recursivenomad/index-audio-amplifier/README.md

🎧 **Tiny USB-C audio amplifier for off-ear BMR speakers**
===========================================================

&nbsp;

> &nbsp;
> ### ***Work in progress***
> &nbsp;

&nbsp;

***Features***
==============

*Coming soon...*

&nbsp;

***How to use***
================

*Coming soon...*

&nbsp;

***License / Access***
======================

This original work is freely available under your choice of the [*MIT-0*](./LICENSE.txt) license or [*CC0-1.0*][URL-CC0] public domain dedication.  
Although attribution is not required, sharing when you've made something with my work is really cool 💖

----------------------

*Repository: <https://gitlab.com/recursivenomad/index-audio-amplifier/>*  
*Contact: <recursivenomad@protonmail.com>*

----------------------

[URL-MIT-0]: <https://opensource.org/license/mit-0/>
[URL-CC0]: <https://creativecommons.org/publicdomain/zero/1.0/>
