recursivenomad/index-audio-amplifier/src/index-audio-amplifier.kicad_pcb

## KiCad design src/index-audio-amplifier.kicad_pcb (2025-08-19)

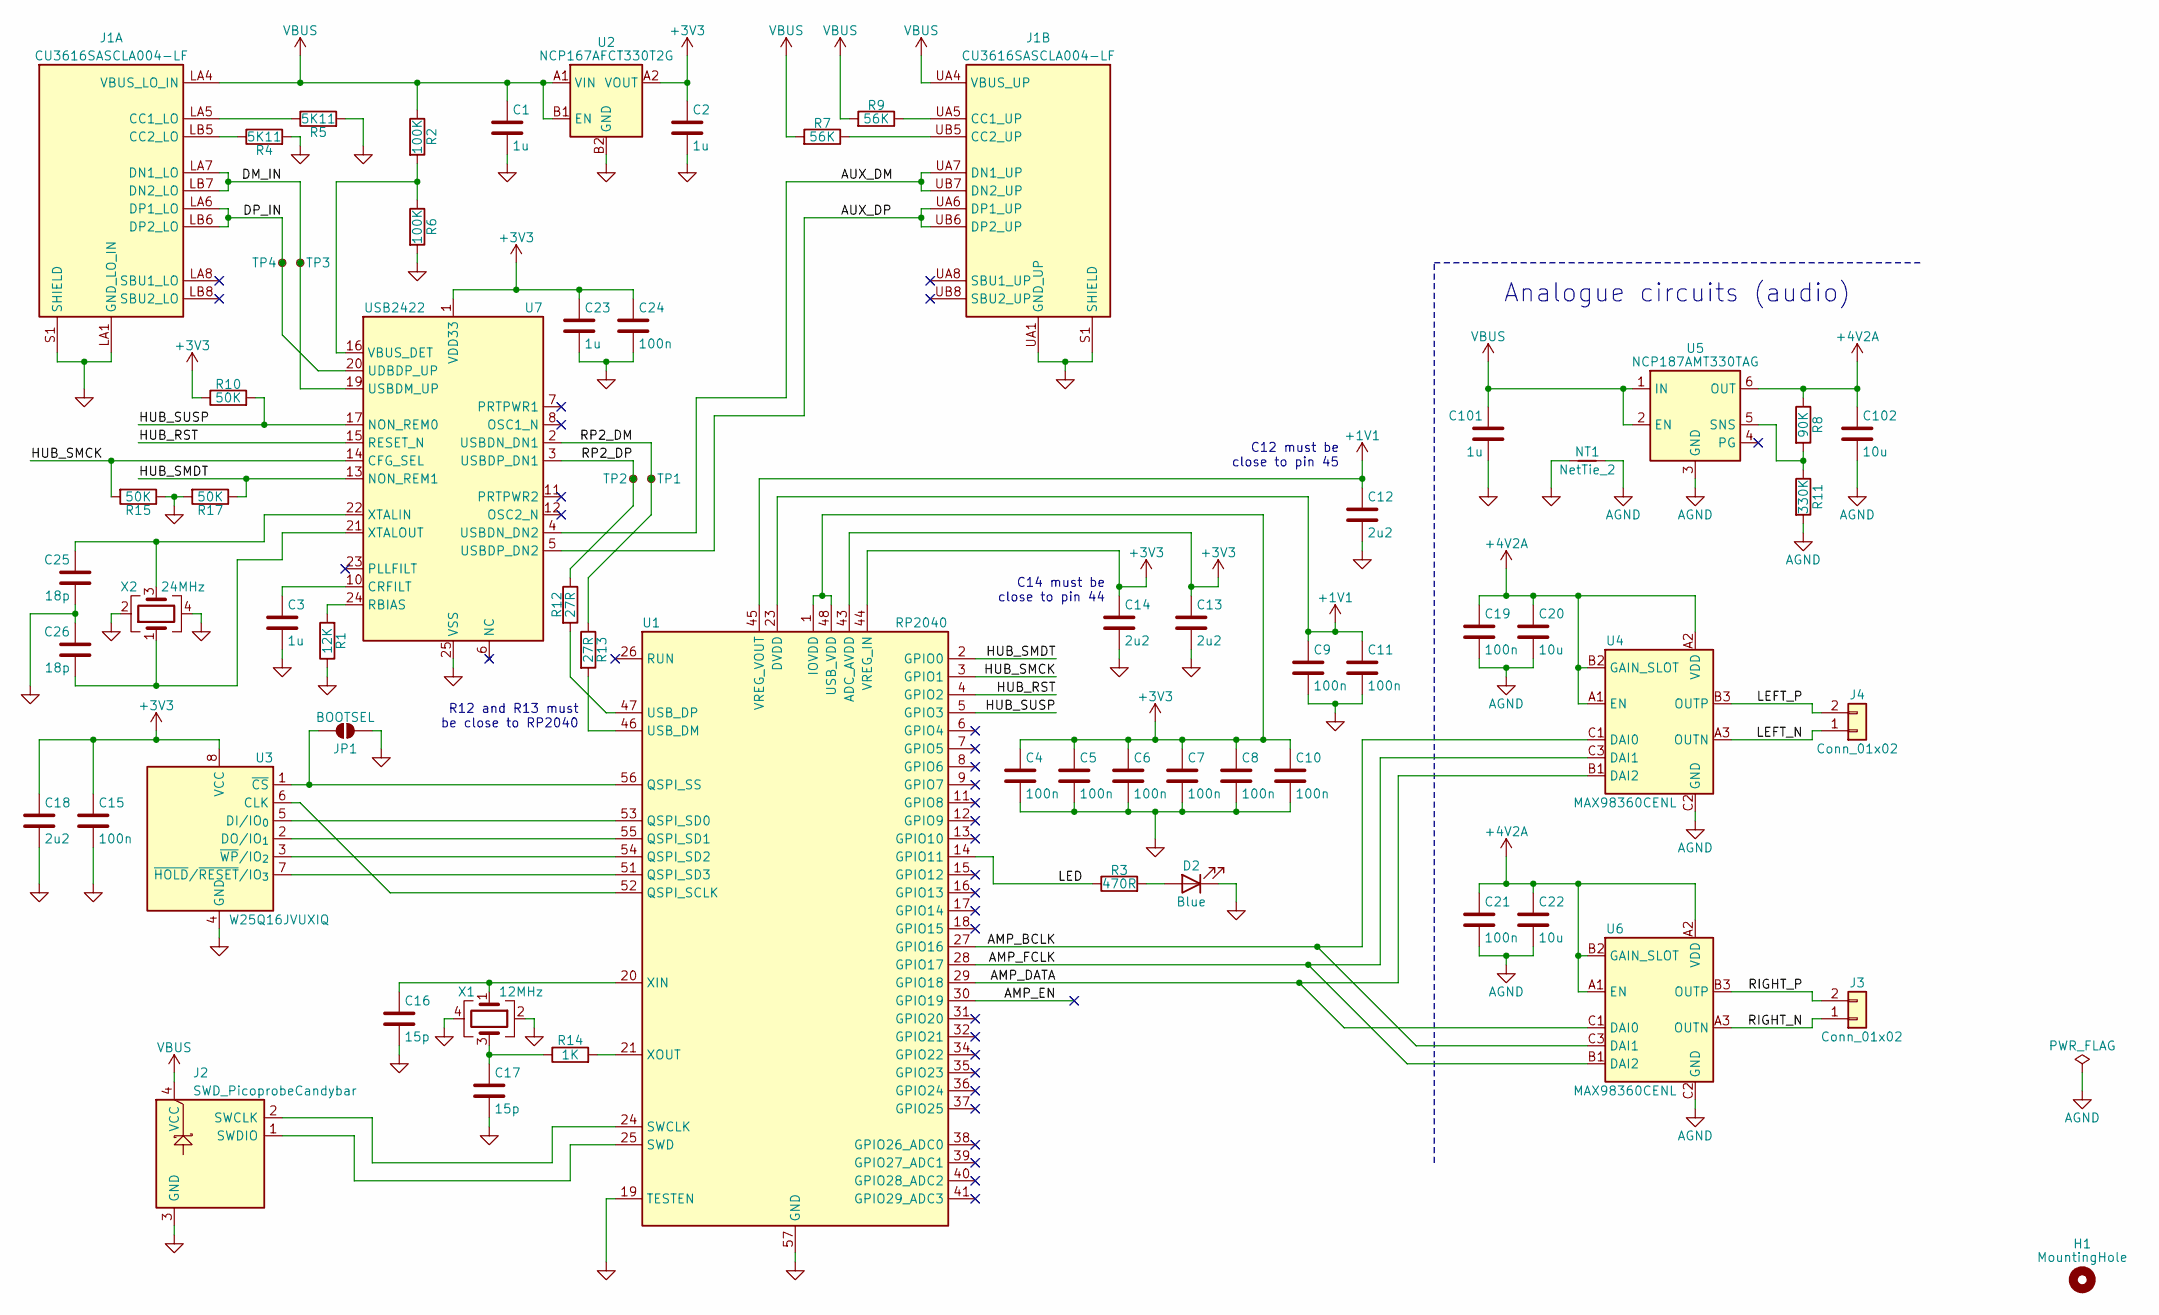
[picture p1: schematic index-audio-amplifier.kicad_sch, Index Audio Amplifier]

Parts:
C1, C2, C3, C23, C101: 1u; C_0402_1005Metric
C4, C5, C6, C7, C8, C9, C10, C11, C15, C19, C21, C24: 100n; C_0402_1005Metric
C12, C13, C14: 2u2; C_01005_0402Metric
C16, C17: 15p; C_0402_1005Metric
C18: 2u2; C_0402_1005Metric
C20, C22, C102: 10u; C_0402_1005Metric
C25, C26: 18p; C_0402_1005Metric
D2: Blue; LED_0603_1608Metric
H1: MountingHole; MountingHole_2.2mm_M2_ISO7380
J1: CU3616SASCLA004-LF; USB_C_Receptacle_CviLux_CU36SASCLA004-LF
J2: SWD_PicoprobeCandybar; SWD_PicoprobeCandybar_PressFit_Compact
J3, J4: Conn_01x02; PinHeader_1x02_P1.00mm_Vertical
JP1: BOOTSEL; SolderJumper-2_P1.0mm_Open_RoundedPad0.5x1.0mm
NT1: NetTie_2; NetTie-2_SMD_Pad0.5mm
R1: 12K; R_0402_1005Metric
R2, R6: 100K; R_0402_1005Metric
R3: 470R; R_0402_1005Metric
R4, R5: 5K11; R_0402_1005Metric
R7, R9: 56K; R_0402_1005Metric
R8: 90K; R_0402_1005Metric
R10, R15, R17: 50K; R_0402_1005Metric
R11: 330K; R_0402_1005Metric
R12, R13: 27R; R_0402_1005Metric
R14: 1K; R_0402_1005Metric
TP1, TP2, TP3, TP4: TestPoint_Small; TestPoint_Pad_D0.5mm
U1: RP2040; QFN-56-1EP_7x7mm_P0.4mm_EP3.2x3.2mm
U2: NCP167AFCT330T2G; WLCSP-4_0.64x0.64mm_Layout2x2_P0.35mm
U3: W25Q16JVUXIQ; Winbond_USON-8-1EP_3x2mm_P0.5mm_EP0.2x1.6mm
U4, U6: MAX98360CENL; WLP-9_1.347x1.347mm_Layout3x3_P0.4mm
U5: NCP187AMT330TAG; DFN-6-1EP_2x2mm_P0.65mm_EP1.01x1.7mm
U7: USB2422; VQFN-24-1EP_4x4mm_P0.5mm_EP2.5x2.5mm_ThermalVias
X1: 12MHz; Crystal_SMD_3225-4Pin_3.2x2.5mm
X2: 24MHz; Crystal_SMD_3225-4Pin_3.2x2.5mm

Connections:
+1V1: C9.1, C11.1, C12.1, U1.23 (DVDD), U1.45 (VREG_VOUT), U1.50 (DVDD)
+3V3: C2.1, C4.1, C5.1, C6.1, C7.1, C8.1, C10.1, C13.1, C14.1, C15.1, C18.1, C23.1, C24.1, R10.1, U1.1 (IOVDD), U1.10 (IOVDD), U1.22 (IOVDD), U1.33 (IOVDD), U1.42 (IOVDD), U1.43 (ADC_AVDD), U1.44 (VREG_IN), U1.48 (USB_VDD), U1.49 (IOVDD), U2.A2 (VOUT), U3.8 (VCC), U7.1 (VDD33), U7.9 (VDD33), U7.18 (VDD33)
+4V2A: C19.1, C20.1, C21.1, C22.1, C102.1, R8.1, U4.A1 (EN), U4.A2 (VDD), U4.B2 (GAIN_SLOT), U5.6 (OUT), U6.A1 (EN), U6.A2 (VDD), U6.B2 (GAIN_SLOT)
/AMP_BCLK: U1.27 (GPIO16), U4.C1 (DAI0), U6.C3 (DAI1)
/AMP_DATA: U1.29 (GPIO18), U4.B1 (DAI2), U6.C1 (DAI0)
/AMP_EN: U1.30 (GPIO19)
/AMP_FCLK: U1.28 (GPIO17), U4.C3 (DAI1), U6.B1 (DAI2)
/AUX_DM: J1.UA7 (DN1_UP), J1.UB7 (DN2_UP), U7.4 (USBDN_DN2)
/AUX_DP: J1.UA6 (DP1_UP), J1.UB6 (DP2_UP), U7.5 (USBDP_DN2)
/DM_IN: J1.LA7 (DN1_LO), J1.LB7 (DN2_LO), TP3.1, U7.19 (USBDM_UP)
/DP_IN: J1.LA6 (DP1_LO), J1.LB6 (DP2_LO), TP4.1, U7.20 (UDBDP_UP)
/HUB_RST: U1.4 (GPIO2), U7.15 (RESET_N)
/HUB_SMCK: R15.2, U1.3 (GPIO1), U7.14 (CFG_SEL)
/HUB_SMDT: R17.1, U1.2 (GPIO0), U7.13 (NON_REM1)
/HUB_SUSP: R10.2, U1.5 (GPIO3), U7.17 (NON_REM0)
/LED: R3.1, U1.14 (GPIO11)
/LEFT_N: J4.1, U4.A3 (OUTN)
/LEFT_P: J4.2, U4.B3 (OUTP)
/RIGHT_N: J3.1, U6.A3 (OUTN)
/RIGHT_P: J3.2, U6.B3 (OUTP)
/RP2_DM: R13.1, TP1.1, U7.2 (USBDN_DN1)
/RP2_DP: R12.1, TP2.1, U7.3 (USBDP_DN1)
AGND: C19.2, C20.2, C21.2, C22.2, C102.2, NT1.2, R11.2, U4.C2 (GND), U5.3 (GND), U5.7 (GND), U6.C2 (GND)
GND: C1.2, C2.2, C3.2, C4.2, C5.2, C6.2, C7.2, C8.2, C9.2, C10.2, C11.2, C12.2, C13.2, C14.2, C15.2, C16.2, C17.2, C18.2, C23.2, C24.2, C25.2, C26.1, C101.2, D2.1 (K), J1.LA1 (GND_LO_IN), J1.LA12 (GND_LO), J1.LB1 (GND_LO), J1.LB12 (GND_LO), J1.S1 (SHIELD), J1.UA1 (GND_UP), J1.UA12 (GND_UP), J1.UB1 (GND_UP), J1.UB12 (GND_UP), J2.3 (GND), JP1.2 (B), NT1.1, R1.1, R4.2, R5.2, R6.2, R15.1, R17.2, U1.19 (TESTEN), U1.57 (GND), U2.B2 (GND), U3.4 (GND), U7.25 (VSS), X1.2, X1.4, X2.2, X2.4
unnamed: C17.1, R14.1, X1.3
unnamed: D2.2 (A), R3.2
unnamed: J1.LA5 (CC1_LO), R5.1
unnamed: J1.LB5 (CC2_LO), R4.1
unnamed: J1.UA5 (CC1_UP), R9.1
unnamed: J1.UB5 (CC2_UP), R7.1
unnamed: J2.2 (SWCLK), U1.24 (SWCLK)
unnamed: J2.1 (SWDIO), U1.25 (SWD)
unnamed: JP1.1 (A), U1.56 (QSPI_SS), U3.1 (~CS)
unnamed: U1.52 (QSPI_SCLK), U3.6 (CLK)
unnamed: U1.53 (QSPI_SD0), U3.5 (DI/IO_{0})
unnamed: U1.55 (QSPI_SD1), U3.2 (DO/IO_{1})
unnamed: U1.54 (QSPI_SD2), U3.3 (~WP/IO_{2})
unnamed: U1.51 (QSPI_SD3), U3.7 (~HOLD/~RESET/IO_{3})
unnamed: R13.2, U1.46 (USB_DM)
unnamed: R12.2, U1.47 (USB_DP)
unnamed: C16.1, U1.20 (XIN), X1.1
unnamed: R14.2, U1.21 (XOUT)
unnamed: R8.2, R11.1, U5.5 (SNS)
unnamed: C3.1, U7.10 (CRFILT)
unnamed: R1.2, U7.24 (RBIAS)
unnamed: R2.2, R6.1, U7.16 (VBUS_DET)
unnamed: C25.1, U7.22 (XTALIN), X2.3
unnamed: C26.2, U7.21 (XTALOUT), X2.1
VBUS: C1.1, C101.1, J1.LA4 (VBUS_LO_IN), J1.LA9 (VBUS_LO), J1.LB4 (VBUS_LO), J1.LB9 (VBUS_LO), J1.UA4 (VBUS_UP), J1.UA9 (VBUS_UP), J1.UB4 (VBUS_UP), J1.UB9 (VBUS_UP), J2.4 (VCC), R2.1, R7.2, R9.2, U2.A1 (VIN), U2.B1 (EN), U5.1 (IN), U5.2 (EN)

Notes on the sheet:
C14 must be close to pin 44
R12 and R13 must be close to RP2040
C12 must be close to pin 45
Analogue circuits (audio)

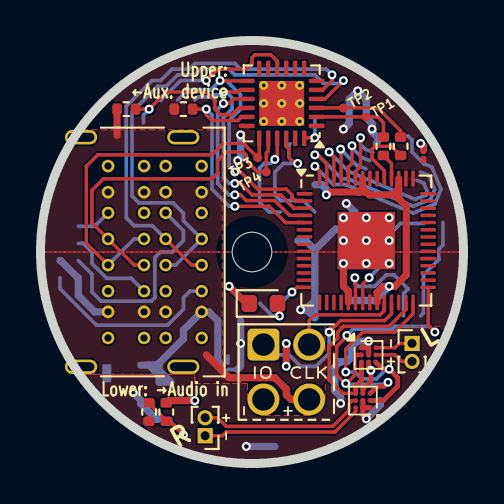
[picture p2: board index-audio-amplifier.kicad_pcb from above]

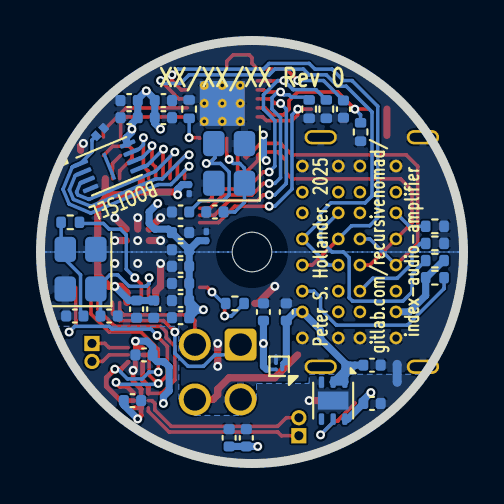
[picture p3: board index-audio-amplifier.kicad_pcb from below]

Board: 2 copper layers, 23.5 x 23.5 mm, 65 parts (45 on the bottom side), 48 nets.
