recursivenomad/index-audio-amplifier/(commit log)

2025-08-12 Initialize project
    KiCad 9.0.3
    [index-audio-amplifier.kicad_pcb, index-audio-amplifier.kicad_sch]
2025-08-12 Initialize project files
    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
    [index-audio-amplifier.kicad_pcb, index-audio-amplifier.kicad_sch]
2025-08-12 Add & associate `compact-title-block` submodule
    [index-audio-amplifier.kicad_pcb, index-audio-amplifier.kicad_sch]
2025-08-13 Draw targeted in-situ reference for board layout
    Geometry approximated from Valve Index HMD using calipers
    [index-audio-amplifier.kicad_pcb]
2025-08-13 Create board edge, 0.5mm clearance from nominal
    [index-audio-amplifier.kicad_pcb]
2025-08-13 Recreate Pico schematic (ignoring connectors)
    <https://datasheets.raspberrypi.com/pico/pico-datasheet.pdf#pico-schematic-diagram>
    [index-audio-amplifier.kicad_sch]
2025-08-13 Add discrete component proximity notes
    Notes adopted from `RP2040_minimal_r2.kicad_pro` in "Minimal-KiCAD.zip"
    from "Hardware design with RP2040":
    <https://datasheets.raspberrypi.com/rp2040/hardware-design-with-rp2040.pdf#minimal-design-example>
    [index-audio-amplifier.kicad_sch]
2025-08-13 Add PCM5101A for `usb_sound_card` firmware
    Component selection adopted from `pico_vga_sd_aud.pro` in
    "VGA_KiCAD.zip" from "Hardware design with RP2040":
    <https://datasheets.raspberrypi.com/rp2040/hardware-design-with-rp2040.pdf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>
    Referenced firmware is on the branch `usb-sound-card` in the
    index-audio-interface repository:
    <https://gitlab.com/recursivenomad/index-audio-interface/-/tree/usb-sound-card/>
    Which itself is rebased from Raspberry Pi's pico-playground repository:
    <https://github.com/raspberrypi/pico-playground/tree/master/apps/usb_sound_card>
    [index-audio-amplifier.kicad_sch]
2025-08-13 Move I2S pins to match `picoamp` firmware
    Refererenced firmware is on the branch `picoamp-rebase` in the
    <https://gitlab.com/recursivenomad/index-audio-interface/-/tree/picoamp-rebase/>
    Which itself is rebased from sctanf's picoamp `main` branch:
    <https://github.com/sctanf/picoamp/>
    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
    [index-audio-amplifier.kicad_sch]
2025-08-13 Replace PCM5101A with 2 MAX98360CENL
    Should be functionally matched to the picoamp firmware now.
    Schematic follows stereo "Typical Application Circuit" from MAX98360x
    datasheet:
    <https://www.analog.com/media/en/technical-documentation/data-sheets/max98360a-max98360d.pdf>
    [index-audio-amplifier.kicad_sch]
2025-08-13 Remove DNP resistors
    [index-audio-amplifier.kicad_sch]
2025-08-13 Associate remaining footprints
    [index-audio-amplifier.kicad_sch]
2025-08-13 Remove unused analogue VSYS monitor (GPIO29)
    [index-audio-amplifier.kicad_sch]
2025-08-13 Remove external analogue reference
    [index-audio-amplifier.kicad_sch]
2025-08-13 Add debug interface
    [index-audio-amplifier.kicad_sch]
2025-08-13 Add screwhead keepout
    [index-audio-amplifier.kicad_pcb]
2025-08-13 Replace Micro-USB with USC-C
    [index-audio-amplifier.kicad_sch]
2025-08-13 Change audio GND to AGND; add MountingHole
    [index-audio-amplifier.kicad_sch]
2025-08-14 Add connectors for speaker outputs
    [index-audio-amplifier.kicad_sch]
2025-08-14 Change MAX98360CENL footprint to custom WLP-9
    [index-audio-amplifier.kicad_sch]
2025-08-14 Downsize discrete components & swap connectors
    [index-audio-amplifier.kicad_sch]
2025-08-14 Net tie GND to AGND & isolate analogue circuits
    [index-audio-amplifier.kicad_sch]
2025-08-14 Initial layout of primarily analogue section
    Removed screwhead keepout in the process; I figure we'll have a high
    enough standoff to avoid any shorts, as we need all the real estate we
    can get!
    [index-audio-amplifier.kicad_pcb]
2025-08-14 Correct RT6150B footprint & reposition schematic
    [index-audio-amplifier.kicad_sch]
2025-08-14 Consider adding USB hub controller, second port
    Still a major work-in-progress;
    Going to revise heavily after this commit.
    [index-audio-amplifier.kicad_pcb, index-audio-amplifier.kicad_sch]
2025-08-14 Replace singular USB ports with dual stacked port
    [index-audio-amplifier.kicad_sch]
2025-08-15 Add alternate pin definitions to USB2422
2025-08-15 Reposition pins for simpler schematic layout
2025-08-15 Add USB hub controller & dual stacked USB-C port
    Now we can have a port to plug in our audio source, and an auxilliary
    port for plugging in an additional device (such as a face tracker)!
    The setup around USB2422 should ensure it initializes appropriately,
    even when the RP2040 isn't set up to communicate with the USB2422,
    with `*_DN1` being non-removable, and `*_DN2` being removable.
    This will allow for firmware like sctanf's picoamp to be fully drop-in
    compatible, and hopefully allow custom firmware to take advantage of
    the USB2422's SMBus registers.
    [index-audio-amplifier.kicad_sch]
2025-08-15 Remove NC pins from dual USB C port symbol
    They aren't included in the footprint
    [index-audio-amplifier.kicad_sch]
2025-08-15 Add & associate dual stack USB-C port footprint
    Uses placeholder Frankenstein model
    [index-audio-amplifier.kicad_sch]
2025-08-15 Add back mounting hole & more net labels
    [index-audio-amplifier.kicad_sch]
2025-08-15 Update USB2422 footprint to use thermal vias
    Per VSS pin description in datasheet:
    <https://ww1.microchip.com/downloads/aemDocuments/documents/OTH/ProductDocuments/DataSheets/00001726B.pdf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>
    [index-audio-amplifier.kicad_sch]
2025-08-16 Begin design refactor w/ dual stack USB-C port...
    Gonna keep changing dramatically as I settle in on a design approach,
    but wanted to save some layout here as a "checkpoint" to possibly refer
    back to.
    [index-audio-amplifier.kicad_pcb]
2025-08-16 Move USB2422 controls to GPIO0-3 to assist layout
    [index-audio-amplifier.kicad_sch]
2025-08-16 Continue refactoring very compact layout
    Feeling pretty good about this second attempt so far...
    Next up: analogue and power regulation
    [index-audio-amplifier.kicad_pcb, index-audio-amplifier.kicad_sch]
2025-08-16 Tie MAX98360 ENs to VDD to save on traces
    [index-audio-amplifier.kicad_sch]
2025-08-16 Remove VBUS diode to save space (be careful!)
    [index-audio-amplifier.kicad_sch]
2025-08-16 Move LED to GPIO14 to support layout
    (also make LED blue)
    [index-audio-amplifier.kicad_sch]
2025-08-17 Replace all power ICs with NCP167
    Buck/boost as featured on the Raspberry Pi (from which this schematic
    was first based upon) is not needed in this application; voltage will
    always be 5V from VBUS.
    Opted for NCP167 because of its great PSRR, and its cousin NCP1117-3.3
    was mentioned in "Hardware Design with RP2040":
    <https://datasheets.raspberrypi.com/rp2040/hardware-design-with-rp2040.pdf#_input_supply>
    [index-audio-amplifier.kicad_sch]
2025-08-17 Add tiny solder jumper footprint
2025-08-17 Complete initial PCB layout :)
    Remaining DRC errors/warnings should seemingly be "fine"
    The analogue layout (arguably the most important part) was very cramped
    at the end. If refactoring, consider prioritizing analogue as well as
    decoupling capacitor layout first next time.
    But - feels good to have condensed everything into this tiny footprint!!
    [index-audio-amplifier.kicad_pcb]
2025-08-17 Resolve ERC warning; Rectify BOOTSEL jumper label
    Remaining ERC error/warning are valid, but acceptable. Just be careful.
    [index-audio-amplifier.kicad_sch]
2025-08-17 Reposition origin & rotate Index reference drawing
    [index-audio-amplifier.kicad_pcb]
2025-08-17 Give capacitors a tad more space under USB port
    [index-audio-amplifier.kicad_pcb]
2025-08-17 Mildly improve Fab layer text readability
    [index-audio-amplifier.kicad_pcb]
2025-08-17 Add silkscreen text and USB Hub bypass test points
    [index-audio-amplifier.kicad_pcb, index-audio-amplifier.kicad_sch]
2025-08-17 Rotate debug connector text
    [index-audio-amplifier.kicad_pcb]
2025-08-17 Rotate front text to align with mounting angle
    [index-audio-amplifier.kicad_pcb]
2025-08-18 Update power plane geometry
    [index-audio-amplifier.kicad_pcb]
2025-08-19 Replace NCP167 with NCP187
    NCP187 lets us output 4.2V to our amplifiers with SNS feedback.
    <https://www.onsemi.com/download/data-sheet/pdf/ncp187-d.pdf>
    Per the amplifiers' datasheet, this increased VDD will reduce THD+N.
    We choose 4.2V output because we can expect a minimum of 4.5V to be
    delivered to the board per the USB 2.0 specification, and the NCP187
    has a maximum dropout of 220mV. 4.5V - 220mV = 4.28V, so 4.2 it is.
    <https://www.usb.org/document-library/usb-20-specification>
    Setting the MAX98360 gains to 6dB should yield a peak voltage output of
    3.67V, which is well within range of our 4.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
    [index-audio-amplifier.kicad_pcb, index-audio-amplifier.kicad_sch]
2025-08-26 Add keepout around USB-C port standoffs
    Measurements aquired from CviLux's CAD model for the part:
    <https://www.cvilux.com/product?id=123&level=type&text=CU%20Series%20USB%20type%20C%20Connector&product_id=1757>
2025-08-27 Adjust USB-C port courtyard
    Tighten courtyard around non-insertive edges
