recursivenomad/index-audio-amplifier/(notices)

Notices in the files:
src/index-audio-amplifier.kicad_sch:
MIT-0 OR CC0-1.0
